COAST-Lab/SEACOW_Public/README.md

# SEACOW_Public
This includes materials needed to recreate or better understand the SEACOW, or System for Exchange of Atmospheric CO2 with Water
