COAST-Lab/SEACOW_Public/circuit300.png

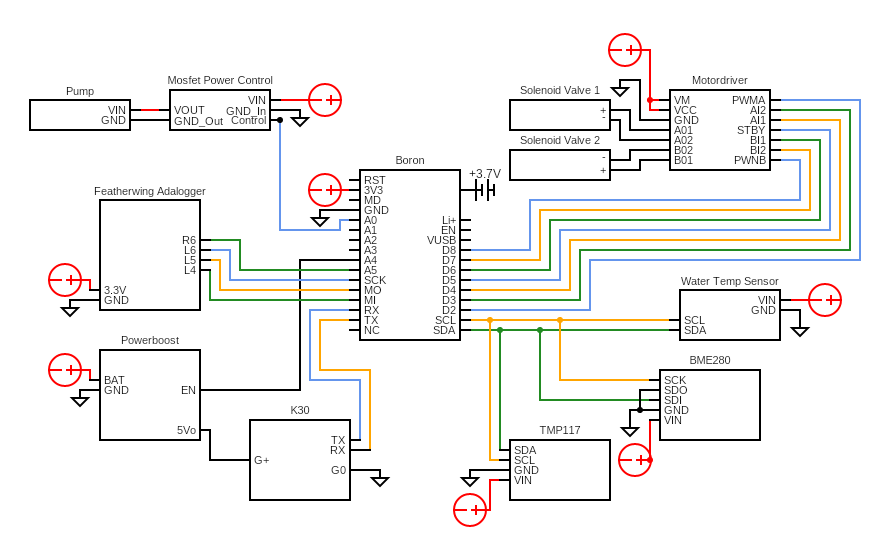
circuit300.png
