COAST-Lab/SEACOW_Public/3D_PrintedParts/README

Includes the .ipt files for all aspects of the SEACOW design that were 3D printed.
