COAST-Lab/SEACOW_Public/Parts_Needed/BillofMaterials.xlsx

Last updated 2/27/2023
 | Name | Part Number | Quantity per SEACOW | Cost per Unit ($) | Total ($) | Description | Link
Electronics | Motordriver | 14450 | 1 | 9.95 | 9.95 | Controls solenoid valves | https://www.sparkfun.com/products/14450
 | Pump | UNMP 05 | 1 | 272.00 | 272.00 | Controls air flow | https://knf.com/en/us/solutions/pumps/series/diaphragm-gas-pump-unmp-05
 | Power Control Kit | 12959 | 1 | 5.25 | 5.25 | Switch that turns on/off pump | https://www.sparkfun.com/products/12959
 | Solenoid valves | LHLA0531211H | 2 | 71.05 | 142.10 | Switches air flow to either air or water side | https://www.theleeco.com/product/lhl-series-2-3-way-control-solenoid-valves/
 | BME Humidity/Temp/Pressure Sensor | 2652 | 1 | 14.95 | 14.95 | For inside K30 Housing | https://www.adafruit.com/product/2652
 | TMP 117 Sensor | 4821 | 1 | 11.5 | 11.50 | For air side temperature | https://www.adafruit.com/product/4821
 | K30 | 030-8-0006 | 1 | 99.00 | 99.00 | CO2 Sensor | https://senseair.com/products/flexibility-counts/k30/
 | Powerboost | 1944 | 1 | 14.95 | 14.95 | Takes 3.3V signal from Boron and boosts it to 5V | https://www.adafruit.com/product/1944
 | Featherwing | 2922 | 1 | 8.95 | 8.95 | Writes to Sd Card | https://www.adafruit.com/product/2922
 | 8 GB Sd | 1294 | 1 | 9.95 | 9.95 | For saving data | https://www.adafruit.com/product/1294
 | Celsius Sensor R1 RP | BR-100317 | 1 | 70.00 | 70.00 | For water side temperature | https://bluerobotics.com/store/sensors-sonars-cameras/sensors/celsius-sensor-r1/
 | 3V CR1220 Coin Battery | 380 | 1 | 0.95 | 0.95 | For featherwing | https://www.adafruit.com/product/380
 | Boron Microcontroller | BRN404X | 1 | 65.31 | 65.31 | Main microcontroller | https://store.particle.io/products/boron-lte-cat-m1-noram-with-ethersim-4th-gen?_pos=1&_sid=0120462a7&_ss=r
 | Solderable Breadboard | 12699 | 1 | 9.95 | 9.95 | Everything is soldered onto this to secure the components | https://www.sparkfun.com/products/12699
 | 3.7 V Li-Ion Battery | 328 | 1 | 14.95 | 14.95 | Powers the Boron | https://www.adafruit.com/product/328
Hardware | Electronics Tray | BR-101011 | 1 | 55.00 | 55.00 | Secure all components to it so it slides in and out of the PVC housing | https://bluerobotics.com/store/watertight-enclosures/4-series/wte4-etray-r1/
 | O-ring Flange | BR-100665 | 2 | 29.00 | 58.00 | Creates waterproof seal | https://bluerobotics.com/store/watertight-enclosures/4-series/wte4-m-flange-seal-r3/
 | M10 Potted Cable Penetrator | BR-101086 | 3 | 4.00 | 12.00 | Allows hole for water-side tubing to attach to and we feed the wires through one for the air-side temp sensor | https://bluerobotics.com/store/cables-connectors/penetrators/penetrator-vp/
 | M10 Cable Penetrator Blank | BR-100434-010 | 2 | 6.00 | 12.00 | Plug for unused holes on the aluminum end cap on water side | https://bluerobotics.com/store/cables-connectors/wlp-blank/
 | Schedule 80 PVC Tube housing (11.75") | 48855K28 | 1 | 15.67 | 15.67 | Housing | https://www.mcmaster.com/48855K28/
 | Enclosure Vent and Plug | BR-100783 | 1 | 9.00 | 9.00 | Vent plug to release pressure during sealing up the housing and can be used to vacuum test system | https://bluerobotics.com/store/cables-connectors/penetrators/vent-asm-r1/
 | 1/16 in Barbed Tube Fitting | 5047K71 | 10 | 0.93 | 9.30 | Barbed hose connection for the all the tubing connections internally and for connecting to the external ePTFE tubing on the waterside | https://www.mcmaster.com/5047K71/
 | Marine Epoxy | BR-100931 | 1 | 10.00 | 10.00 | For sealing the K30 housing, the air temp housing, and potting the barbed tube fittings inside the cable penetrators | https://bluerobotics.com/store/cables-connectors/tools/loctite-marine-epoxy/
 | Valve Filters (inline 35 micron) | TKFA9502135A | 1 | 120.35 | 120.35 | Filters out any particles before air flow enters solenoid valves | https://www.theleeco.com/products/electro-fluidic-systems/minstac-tubing-components/fluid-control-components/filters/
 | Nafion Tubing (24 in) | TUB-003 | 1 | 179 | 179.00 | Drying the air flow before it reaches the K30 housing | https://www.co2meter.com/products/nafion-gas-sample-drying-tubing
 | 10-20 Mesh Drierite Dessicant (1lb) | 24001 | 1 | 17.83 | 17.83 | We place the nafion tubing inside a bag of drierite so it continues to dry the air flow before reaching the K30 electronics | https://secure.drierite.com/catalog3/page4b.cfm?activeMenu=0
 | ePTFE 1.85 mm ID tubing (24 in) | 018-03 | 1 | 20.00 | 20.00 | To be the exchanger on the water side | https://ipeweb.com/oem-components/light-guide-covers/
 | ePTFE CO2 cover (20 cm) | 270-01-S | 1 | 23.00 | 23.00 | Cut to be flat and used as the planar exchanger for the airside | https://ipeweb.com/oem-components/co2-sensor-covers/
 | copper mesh (1 sq feet) | 9224T51 | 1 | 22.97 | 22.97 | To protect the ePTFE membranes from getting knicked and to reduce biofouling | https://www.mcmaster.com/9224T51/
 | Wiring | 11367 | 1 | 21.00 | 5.00 | For soldering connections | https://www.sparkfun.com/products/11367
 | Silicone grease | MOLYKOTE-VP | 1 | 3.00 | 3.00 | For O-rings | https://bluerobotics.com/store/watertight-enclosures/enclosure-tools-supplies/molykote/
 | 4-40 Screws (need 28) | 92185A110 | 1 | 5.75 | 5.75 | For fastening the retainer into the air-side end cap | https://www.mcmaster.com/92185A110/
 | M3 x 0.5 mm x 16 mm screws (need 12) | 92290A120 | 1 | 12.04 | 12.04 | Fastens the tubing holder to the aluminum end cap and O-ring flange on the water side, and fastens the 3D printed end cap to the O-ring flange on the air side | https://www.mcmaster.com/92290A120/
 | 1/8 OD 1/16 ID Impermeable tubing | 1534 | 1 | 64.89 | 64.89 | For all the internal airflow connections | https://www.idex-hs.com/store/product-detail/peek_tubing_natural_1_8_od_x_1_16_id_x_5ft/1534?search=true
 |  |  |  | Total: | 1404.56
