COAST-Lab/SEACOW_Public/Parts_Needed/README

This is the list of the main parts and their prices as of 2023 needed for building a SEACOW
