COAST-Lab/SEACOW_Public/3D_PrintedParts/WaterSideTubingHolder.stl

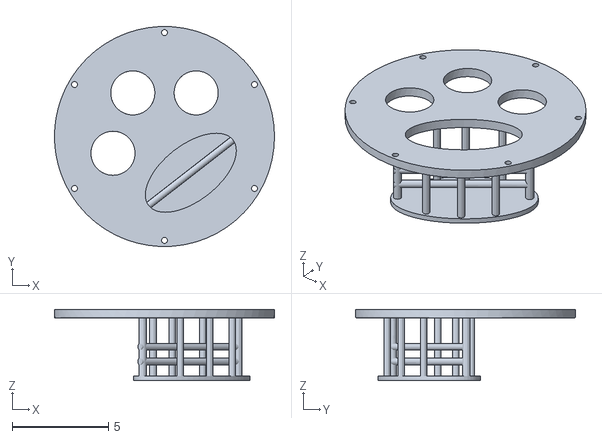
[picture p2: CAD file, 2023-10-16]
3D_PrintedParts/WaterSideTubingHolder.stl
11.4 x 11.4 x 3.69
