COAST-Lab/SEACOW_Public/(list of files, cad)

Other CAD files:
3D_PrintedParts/AirSideTop.ipt
3D_PrintedParts/BottomofAirTempHousing.ipt
3D_PrintedParts/BottomofK30Housing.ipt
3D_PrintedParts/RetainerForAirSideTop.ipt
3D_PrintedParts/TopofAirTempHousing.ipt
3D_PrintedParts/TopofK30Housing.ipt
