COAST-Lab/SEACOW_Public/(commit log)

2023-10-16 Add files via upload
    All 3D-designed parts for the SEACOW. Provided in .ipt format so that they are editable.
    [Bottom_Housing_K30 (3).ipt, Newairtempguybottom.ipt, PTFE_Replacement_Cap (most recent_holes adjusted).ipt, RetainerForTheCap.ipt, Top_Housing_K30_Elipse_O_Ring (1).ipt, capforwaterside (1).stl, newairtempguytop.ipt]
2024-08-02 Rename Bottom_Housing_K30 (3).ipt to BottomofK30Housing.ipt
    [BottomofK30Housing.ipt]
2024-08-02 Rename PTFE_Replacement_Cap (most recent_holes adjusted).ipt to AirSideTop.ipt
    [AirSideTop.ipt]
2024-08-02 Rename Top_Housing_K30_Elipse_O_Ring (1).ipt to TopofK30Housing.ipt
    [TopofK30Housing.ipt]
2024-08-02 Rename capforwaterside (1).stl to WaterSideTubingHolder.stl
    [WaterSideTubingHolder.stl]
2025-04-02 Adding circuit diagram
